JasirVitus/Ultrasonic_water_flowmeter/README.md

# Ultrasonic_water_flowmeter
A device that measures the total flow of water through a pipe. 
The circuit was implemented on a breadboard. 
Water flow measurement using the sound
carrying effect and an analog conditioning circuit.

The device has the following parameters:
- **Power supply voltage:** 7.5V
- **Maximum flow:** 870 cm3/s
- **Measurement frequency:** 2 measurements/s
- **Accuracy:** ~5%
- **Water temperature measurement range:** 10-30°C

<p align="center">
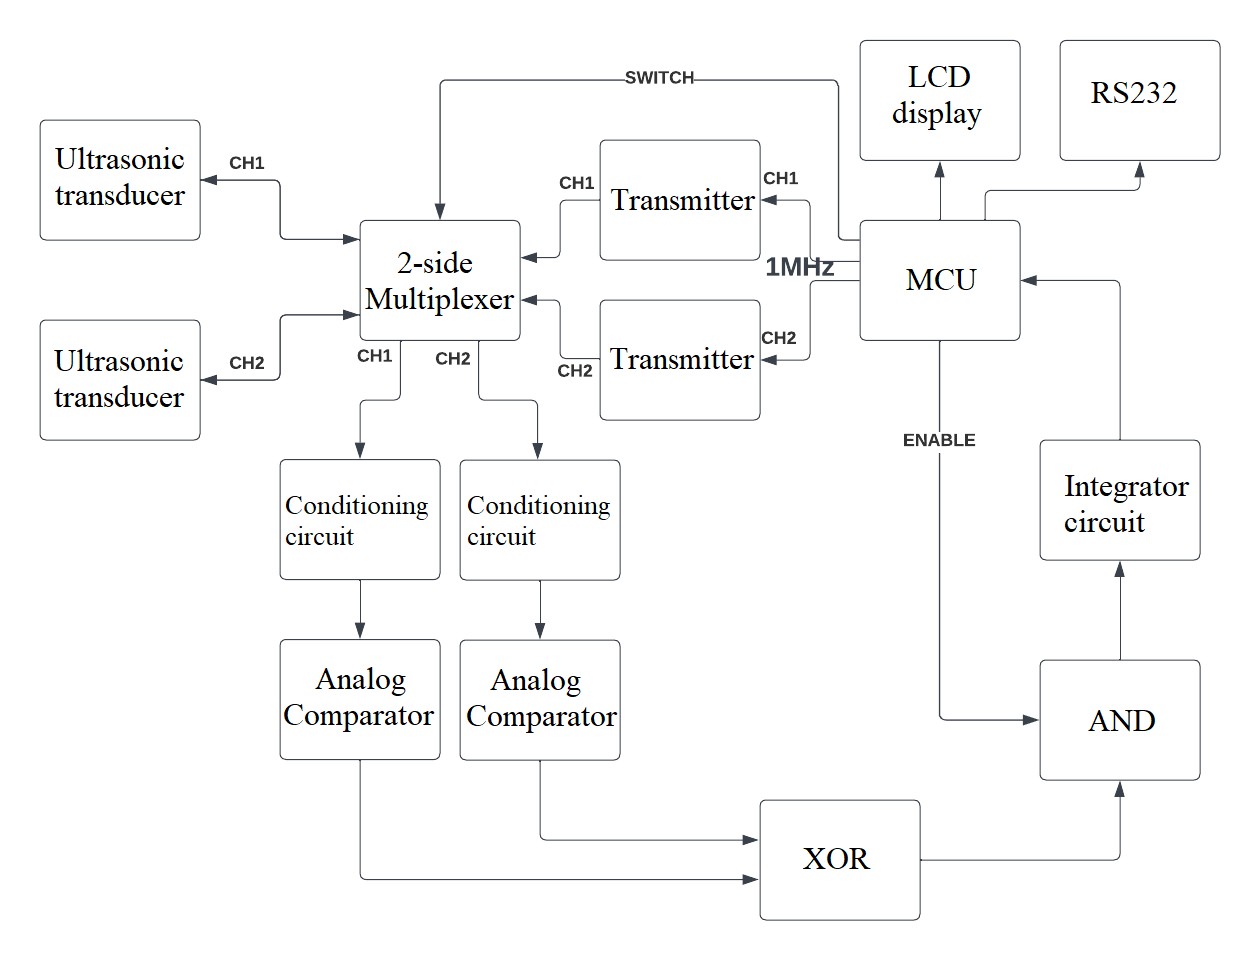
[picture p1: Electrical_schematics/block_diagram.png]

</p>

The ultrasonic transducers were placed opposite each other and the water supply was provided by the two upper holes of the pipe.

<p align="center">
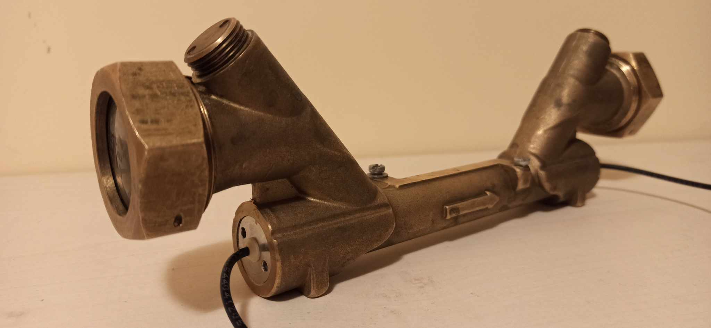
[picture p2: Photos/Mechanical_package.jpg]

</p>
<p align="center">
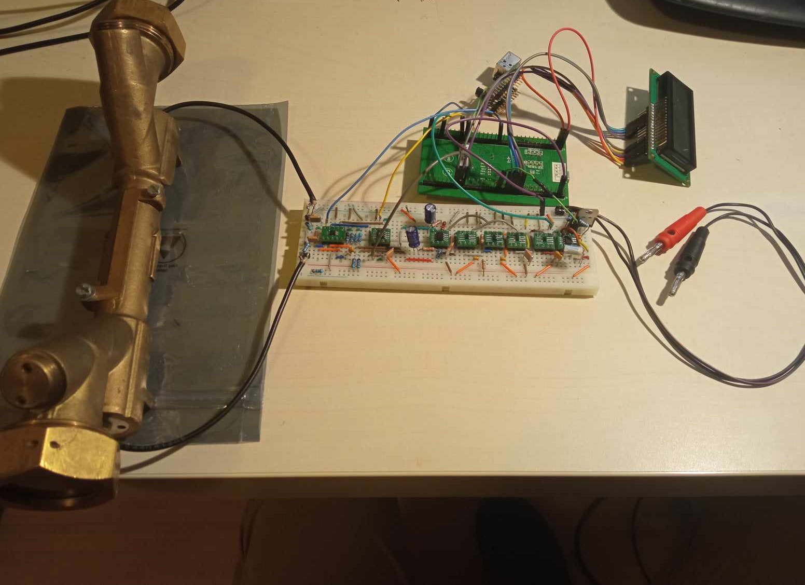
[picture p3: Photos/Electrical_circuit_2.jpg]

</p>
