JasirVitus/Ultrasonic_water_flowmeter/Code/diagram_algorithm.png

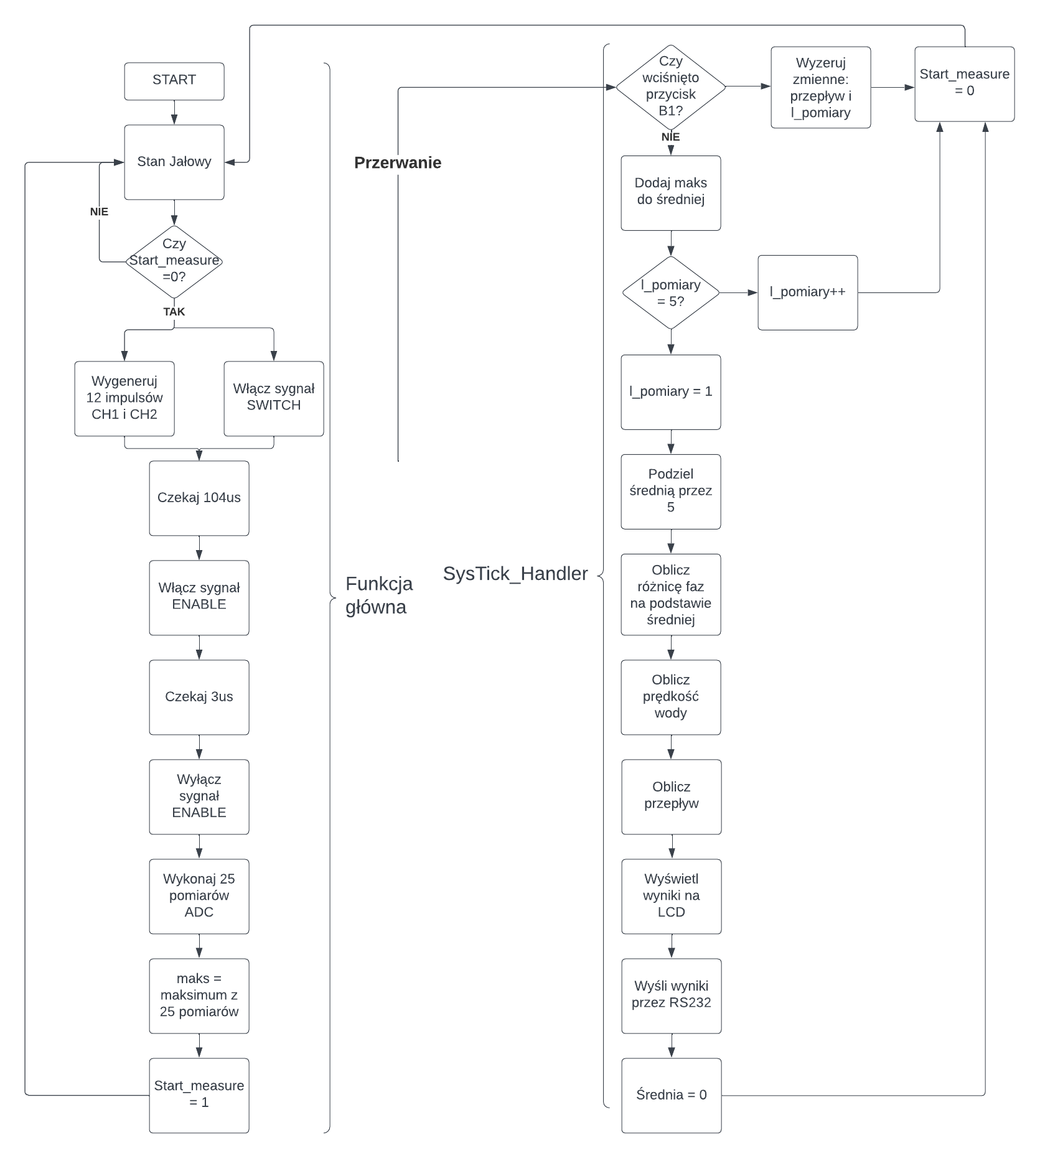
Code/diagram_algorithm.png
