JasirVitus/Ultrasonic_water_flowmeter/Electrical_schematics/schem_1.png

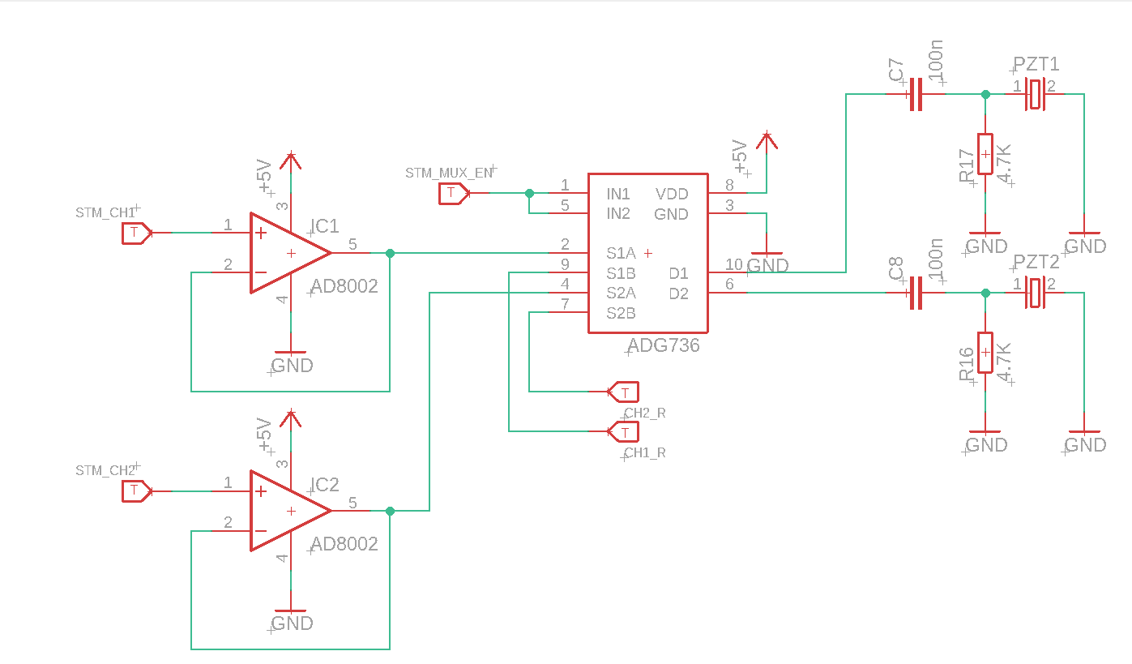
Electrical_schematics/schem_1.png
