JasirVitus/Ultrasonic_water_flowmeter/Electrical_schematics/schem_2.png

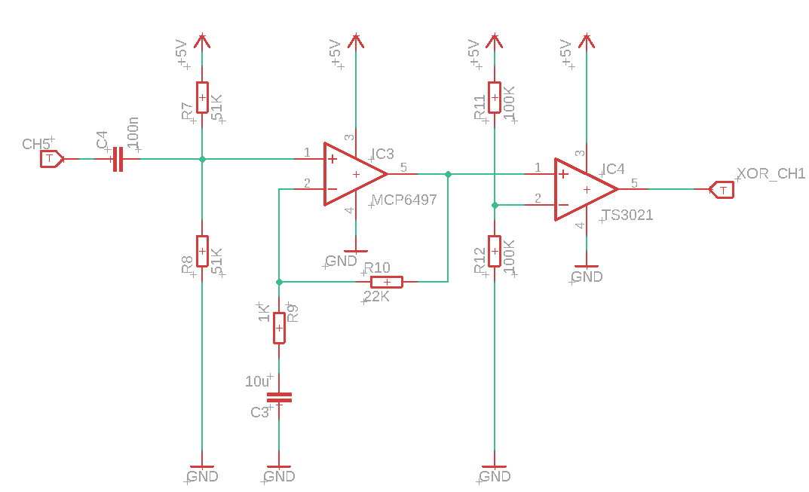
Electrical_schematics/schem_2.png
