JasirVitus/Ultrasonic_water_flowmeter/Electrical_schematics/schem_3.png

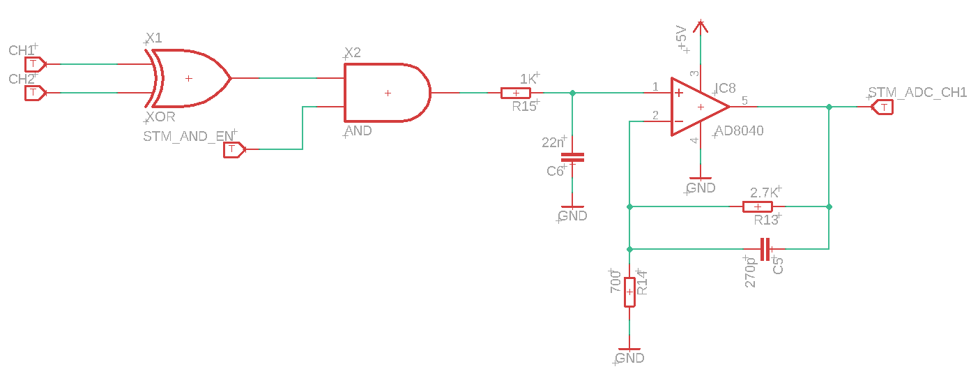
Electrical_schematics/schem_3.png
