JasirVitus/Ultrasonic_water_flowmeter/Photos/Electrical_circuit.jpg

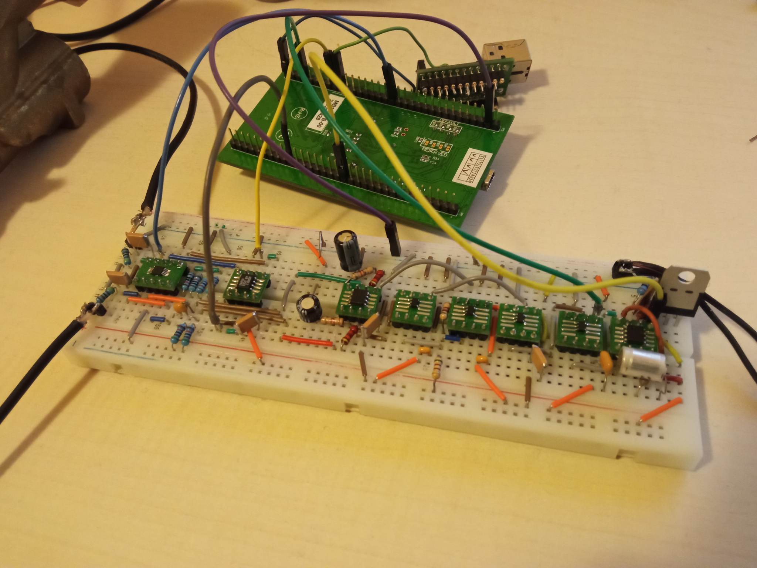
Photos/Electrical_circuit.jpg
