JasirVitus/Ultrasonic_water_flowmeter/Photos/Piezoelectric_transducer.jpg

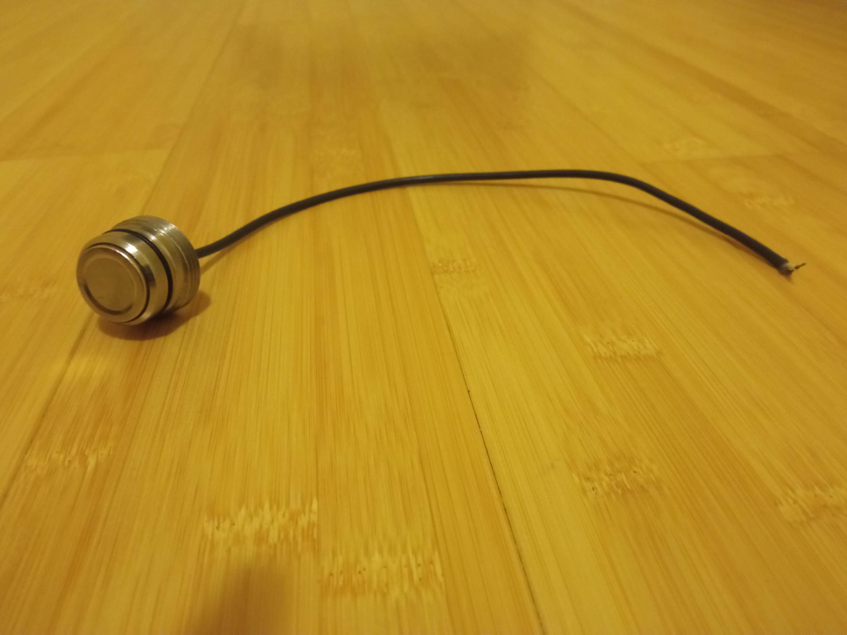
Photos/Piezoelectric_transducer.jpg
