JasirVitus/Ultrasonic_water_flowmeter/Impedance_measurements_of_transducer/head1MHz_water_faza2.jpeg

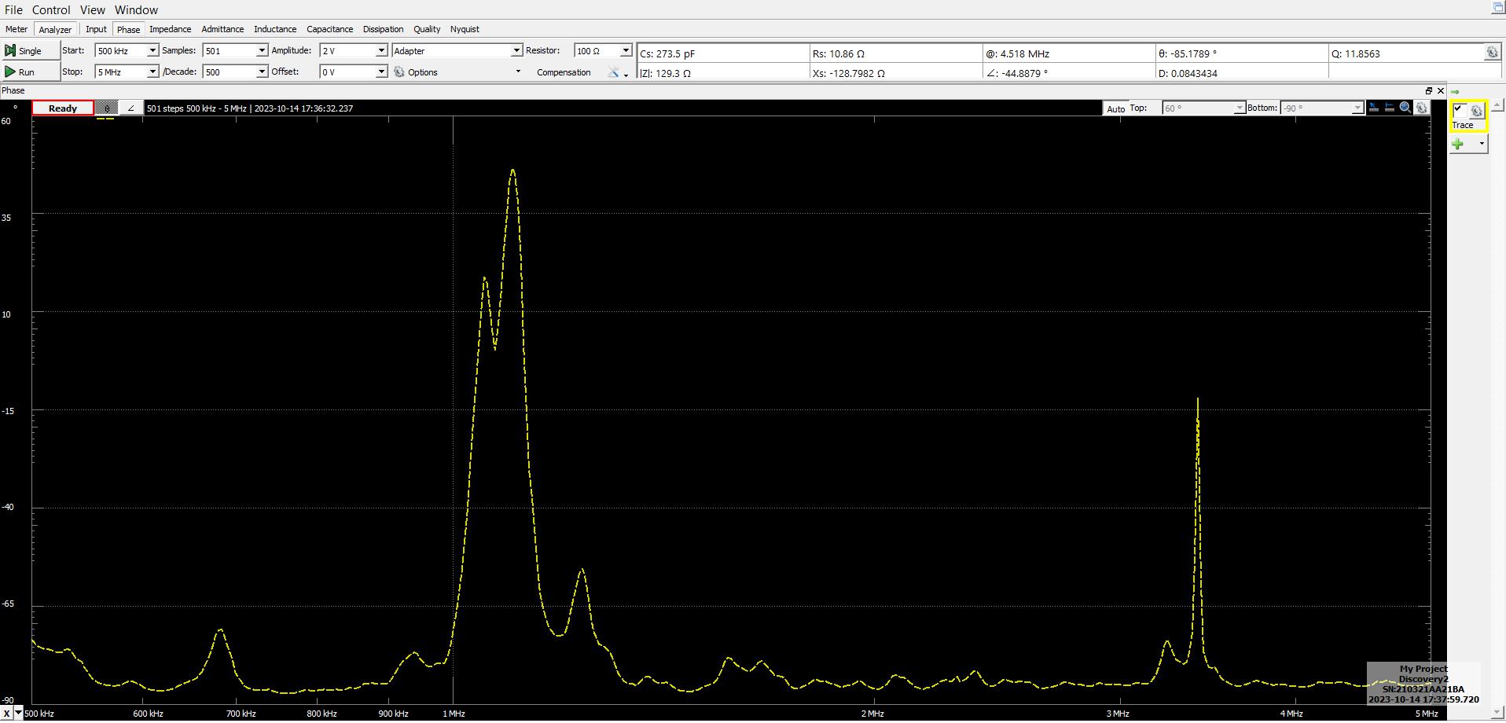
Impedance_measurements_of_transducer/head1MHz_water_faza2.jpeg
