JasirVitus/Ultrasonic_water_flowmeter/Impedance_measurements_of_transducer/head1MHz_water_modul2.jpeg

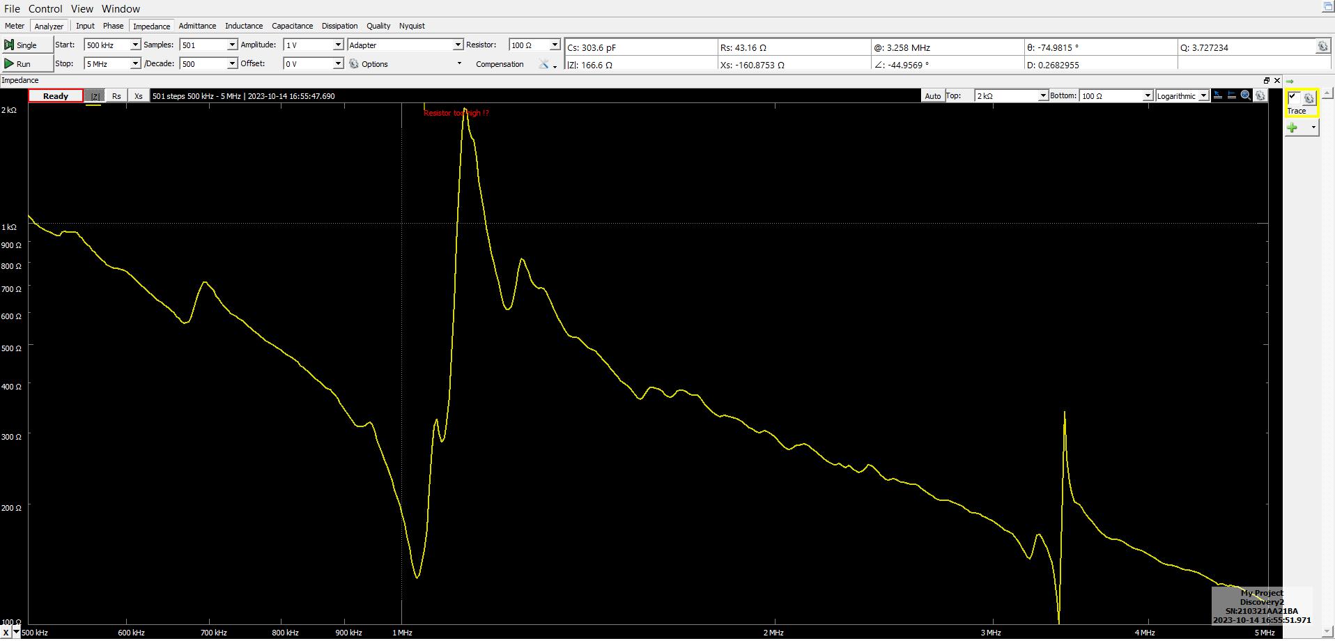
Impedance_measurements_of_transducer/head1MHz_water_modul2.jpeg
