JasirVitus/Ultrasonic_water_flowmeter/Oscilloscope_measurements/tek00004.png

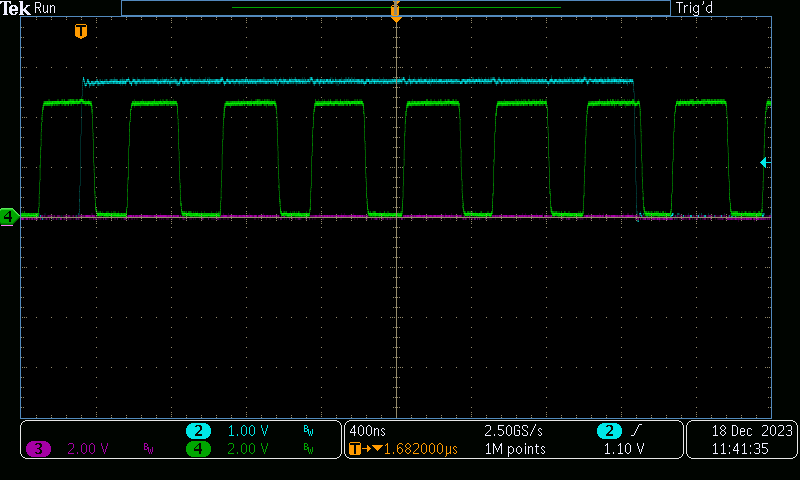
Oscilloscope_measurements/tek00004.png
