JasirVitus/Ultrasonic_water_flowmeter/Oscilloscope_measurements/tek00005.png

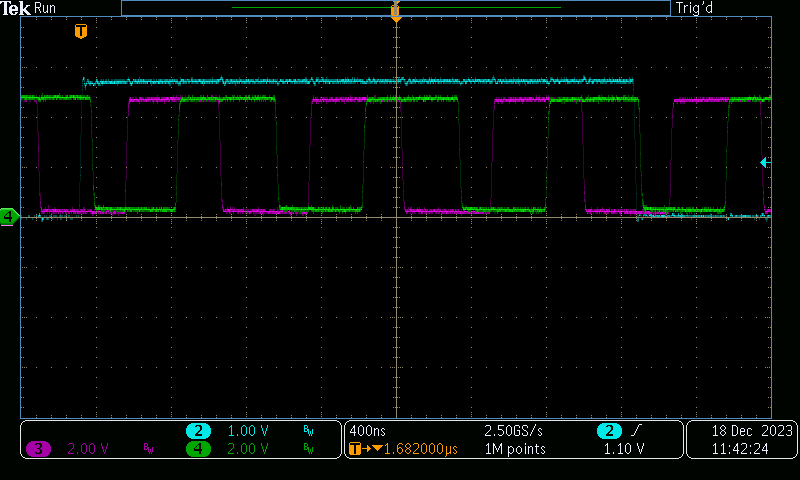
Oscilloscope_measurements/tek00005.png
