JasirVitus/Ultrasonic_water_flowmeter/Oscilloscope_measurements/tek00008.png

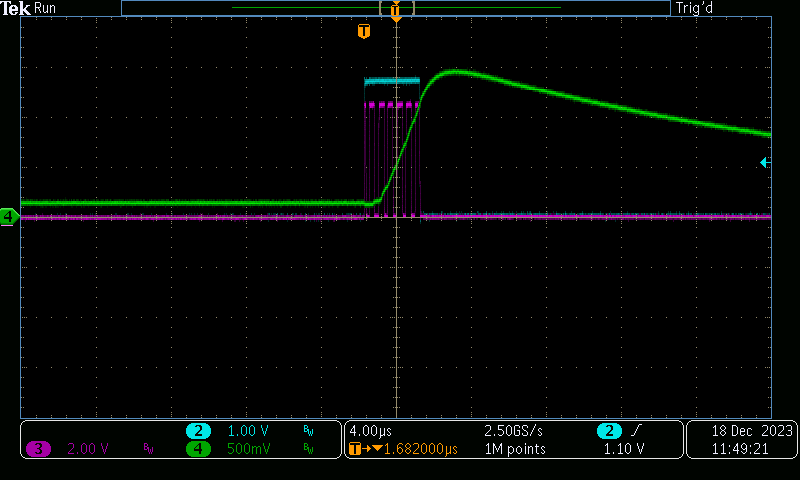
Oscilloscope_measurements/tek00008.png
