JasirVitus/Ultrasonic_water_flowmeter/Oscilloscope_measurements/tek00011.png

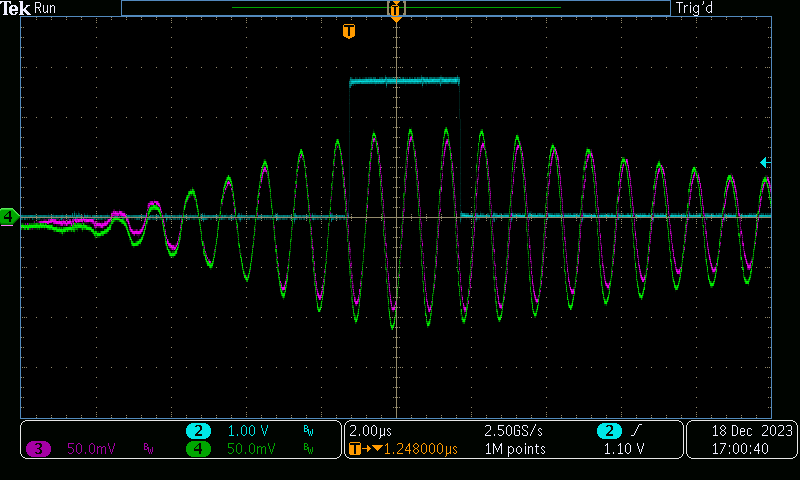
Oscilloscope_measurements/tek00011.png
