JasirVitus/Ultrasonic_water_flowmeter/Oscilloscope_measurements/tek00018.png

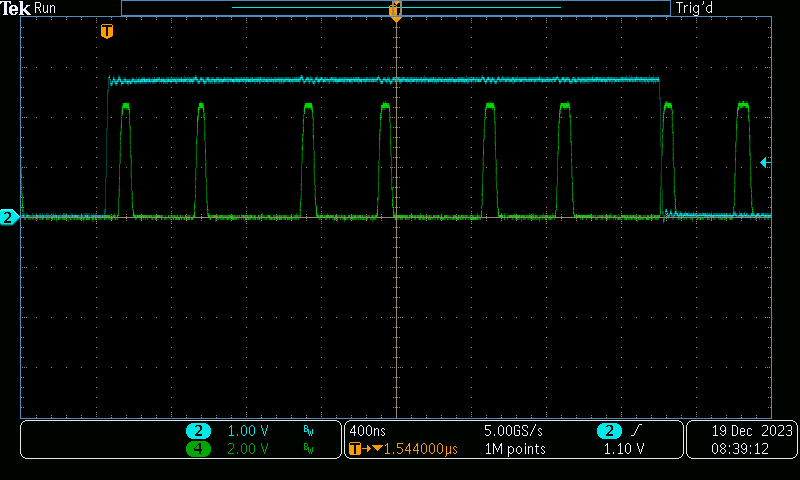
Oscilloscope_measurements/tek00018.png
