JasirVitus/Ultrasonic_water_flowmeter/Oscilloscope_measurements/tek00021.png

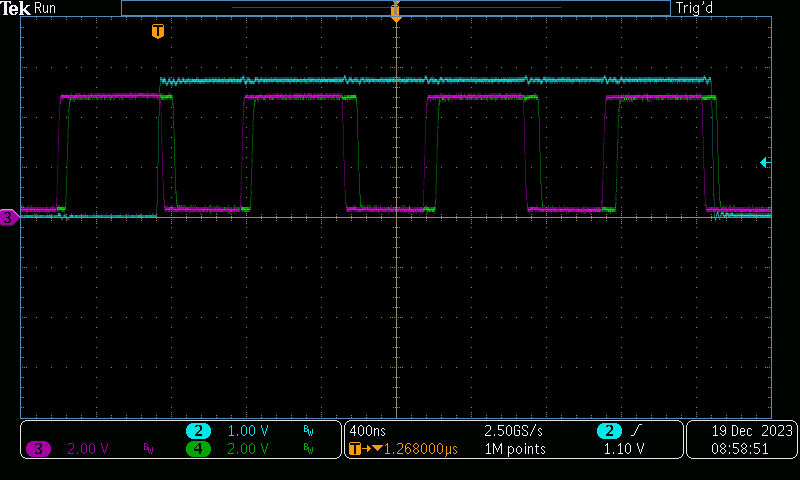
Oscilloscope_measurements/tek00021.png
