JasirVitus/Ultrasonic_water_flowmeter/Electrical_schematics/ultra-flowmeter.sch

## EAGLE design Electrical_schematics/ultra-flowmeter.sch (2025-09-16)

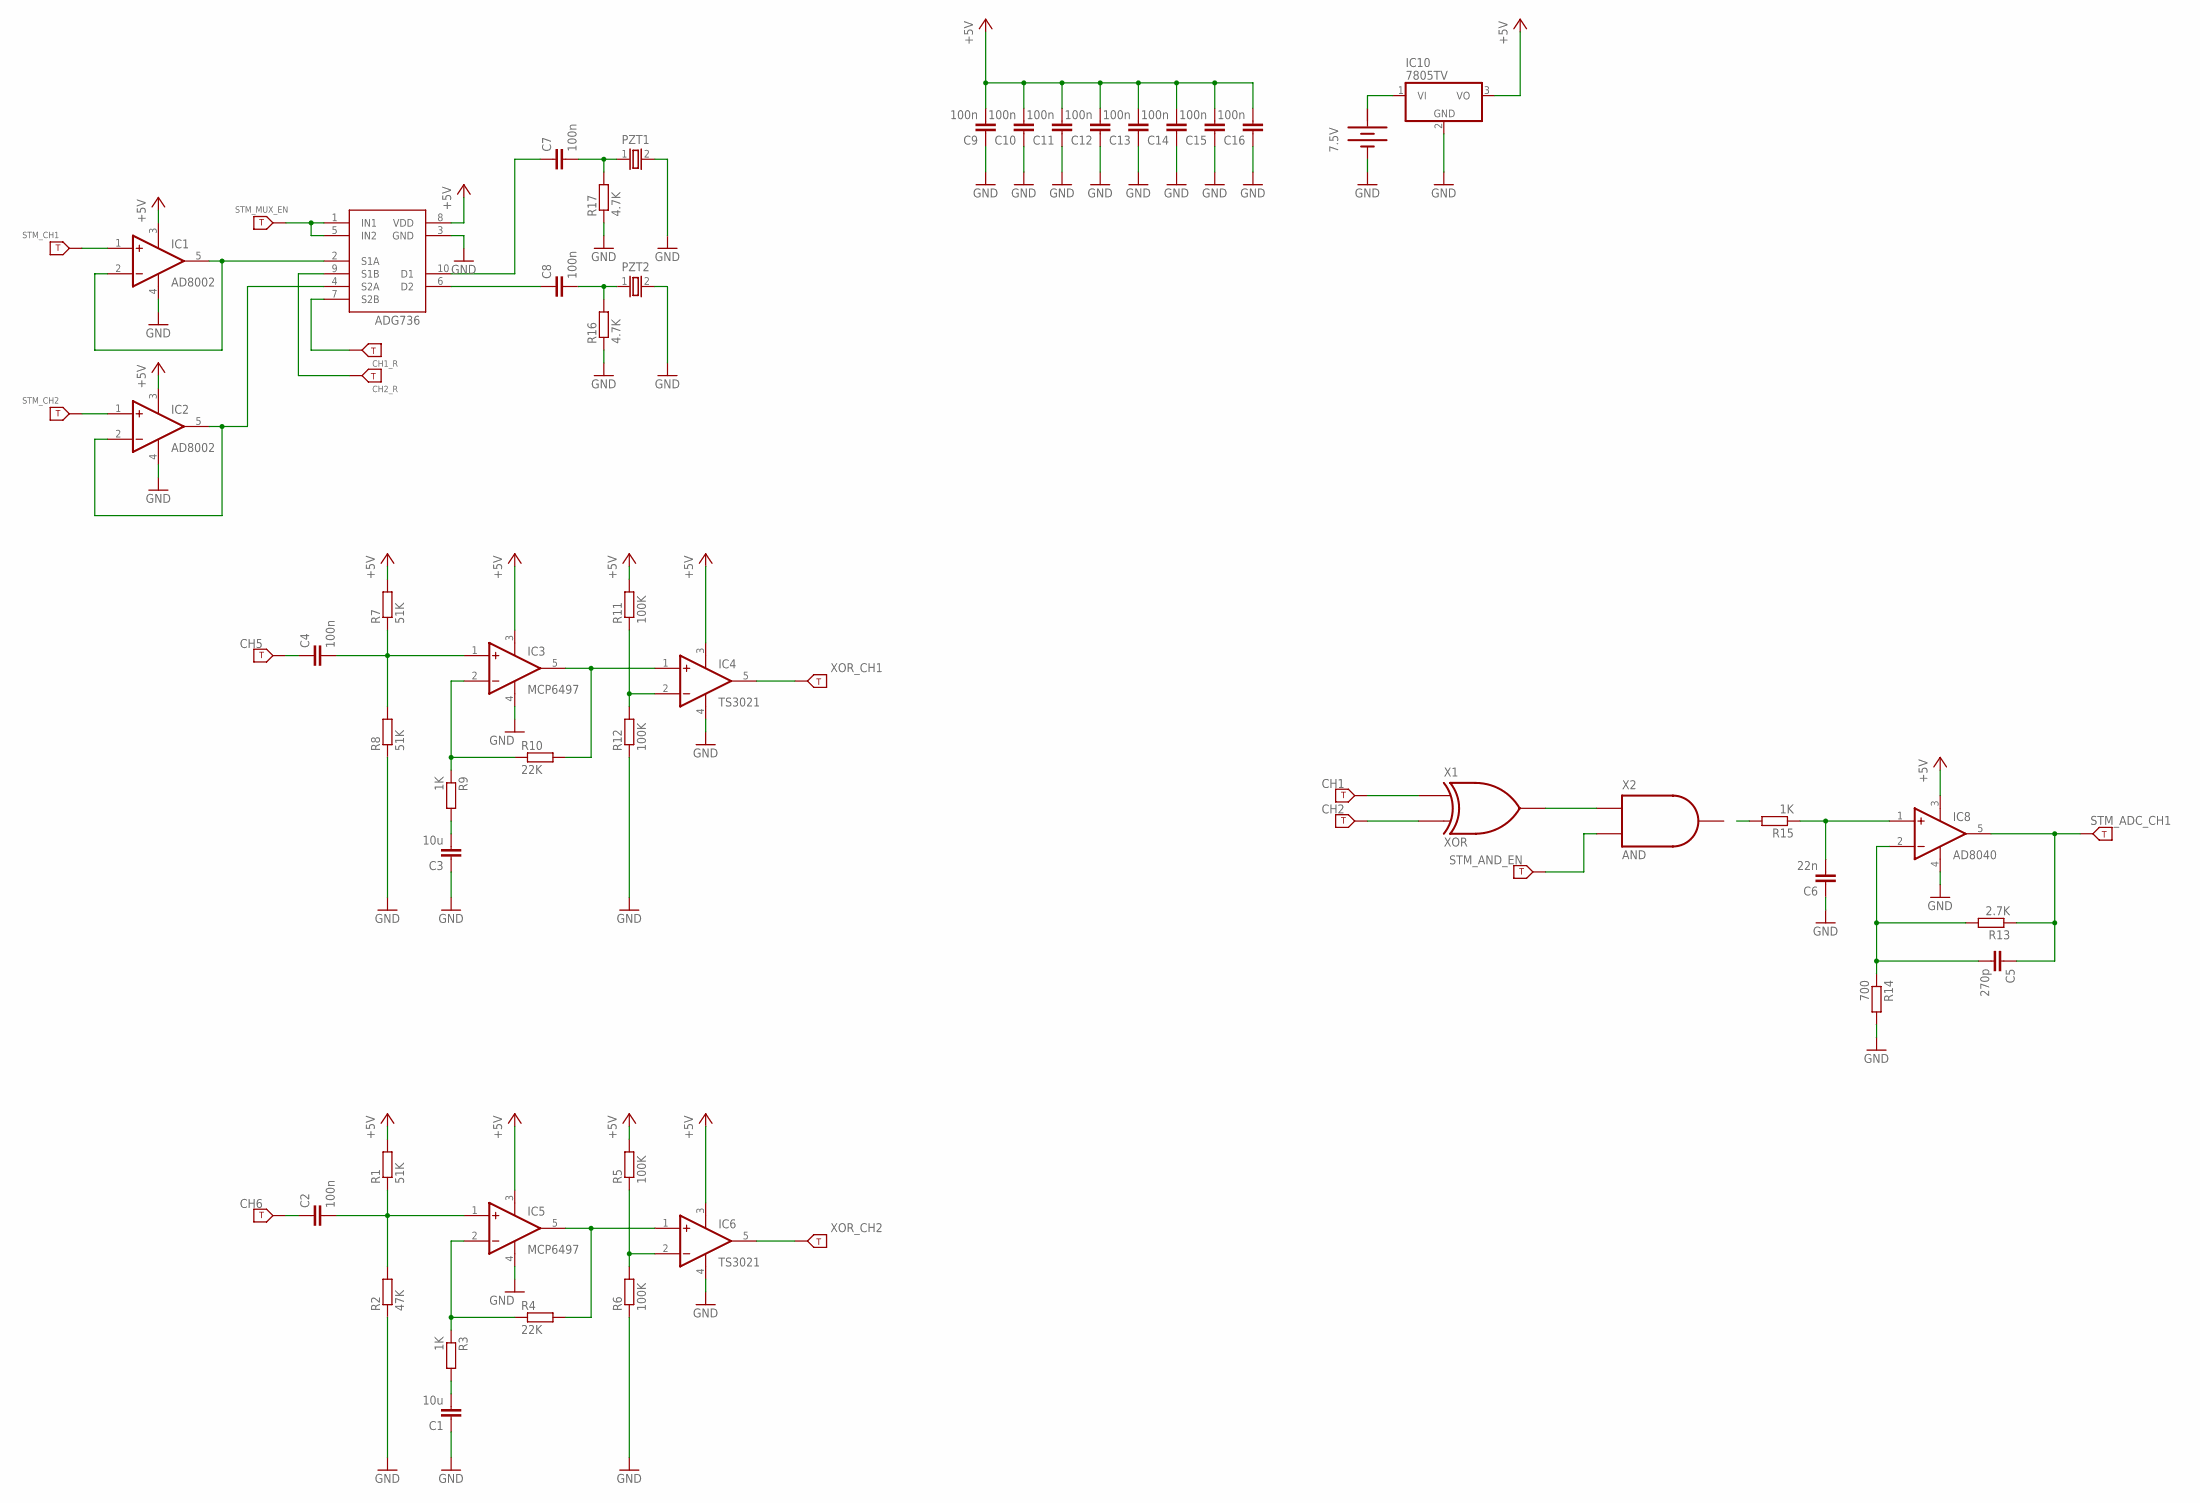
[picture p20: schematic ultra-flowmeter.sch]

Parts:
7.5V: BATTERY
ADG736: ADG736; MSOP10
C1, C3: 10u; C025-025X050
C2, C4, C7, C8, C9, C10, C11, C12, C13, C14, C15, C16: 100n; C025-025X050
C5: 270p; C025-025X050
C6: 22n; C025-025X050
CH1, CH1_R, CH2, CH2_R, CH5, CH6: PAD1
IC1, IC2: AD8002; SO8
IC3, IC5: MCP6497; SO8
IC4, IC6: TS3021; SO8
IC8: AD8040; SO8
IC10: 7805TV; TO220V
PZT1, PZT2: CRYSTAL
R1, R7, R8: 51K; 0207/10
R2: 47K; 0207/10
R3, R9, R15: 1K; 0207/10
R4, R10: 22K; 0207/10
R5, R6, R11, R12: 100K; 0207/10
R13: 2.7K; 0207/10
R14: 700; 0207/10
R16, R17: 4.7K; 0207/10
STM_ADC_CH1: PAD1
STM_AND_EN: PAD1
STM_CH1, STM_CH2: PAD1
STM_MUX_EN: PAD1
XOR_CH1, XOR_CH2: PAD1

Connections:
+5V: ADG736.8 (VDD), C9.2, C10.2, C11.2, C12.2, C13.2, C14.2, C15.2, C16.2, IC1.3 (OFF1), IC2.3 (OFF1), IC3.3 (OFF1), IC4.3 (OFF1), IC5.3 (OFF1), IC6.3 (OFF1), IC8.3 (OFF1), IC10.3 (VO), R1.2, R5.2, R7.2, R11.2
GND: 7.5V.-, ADG736.3 (GND), C1.1, C3.1, C6.1, C9.1, C10.1, C11.1, C12.1, C13.1, C14.1, C15.1, C16.1, IC1.4 (OFF2), IC2.4 (OFF2), IC3.4 (OFF2), IC4.4 (OFF2), IC5.4 (OFF2), IC6.4 (OFF2), IC8.4 (OFF2), IC10.2 (GND), PZT1.2, PZT2.2, R2.1, R6.1, R8.1, R12.1, R14.2, R16.1, R17.1
unnamed: C2.2, IC5.1 (+IN), R1.1, R2.2
unnamed: IC2.1 (+IN), STM_CH2.1
unnamed: IC5.2 (-IN), R3.1, R4.1
unnamed: IC5.5 (OUT), IC6.1 (+IN), R4.2
unnamed: IC6.2 (-IN), R5.1, R6.2
unnamed: C4.2, IC3.1 (+IN), R7.1, R8.2
unnamed: IC3.2 (-IN), R9.1, R10.1
unnamed: IC3.5 (OUT), IC4.1 (+IN), R10.2
unnamed: IC4.2 (-IN), R11.1, R12.2
unnamed: C3.2, R9.2
unnamed: C6.2, IC8.1 (+IN), R15.1
unnamed: C5.2, IC8.2 (-IN), R13.2, R14.1
unnamed: C5.1, IC8.5 (OUT), R13.1, STM_ADC_CH1.1
unnamed: ADG736.2 (S1A), IC1.2 (-IN), IC1.5 (OUT)
unnamed: ADG736.4 (S2A), IC2.2 (-IN), IC2.5 (OUT)
unnamed: C7.2, PZT1.1, R17.2
unnamed: ADG736.6 (D2), C8.1
unnamed: C8.2, PZT2.1, R16.2
unnamed: ADG736.10 (D1), C7.1
unnamed: IC1.1 (+IN), STM_CH1.1
unnamed: C1.2, R3.2
unnamed: IC4.5 (OUT), XOR_CH1.1
unnamed: 7.5V.+, IC10.1 (VI)
unnamed: C4.1, CH5.1
unnamed: IC6.5 (OUT), XOR_CH2.1
unnamed: ADG736.9 (S1B), CH2_R.1
unnamed: ADG736.7 (S2B), CH1_R.1
unnamed: C2.1, CH6.1
STM_MUX_EN: ADG736.1 (IN1), ADG736.5 (IN2), STM_MUX_EN.1
